MarchRaBBiT/RNA/RNA.kicad_pcb

## KiCad design RNA.kicad_pcb (2019-11-05)

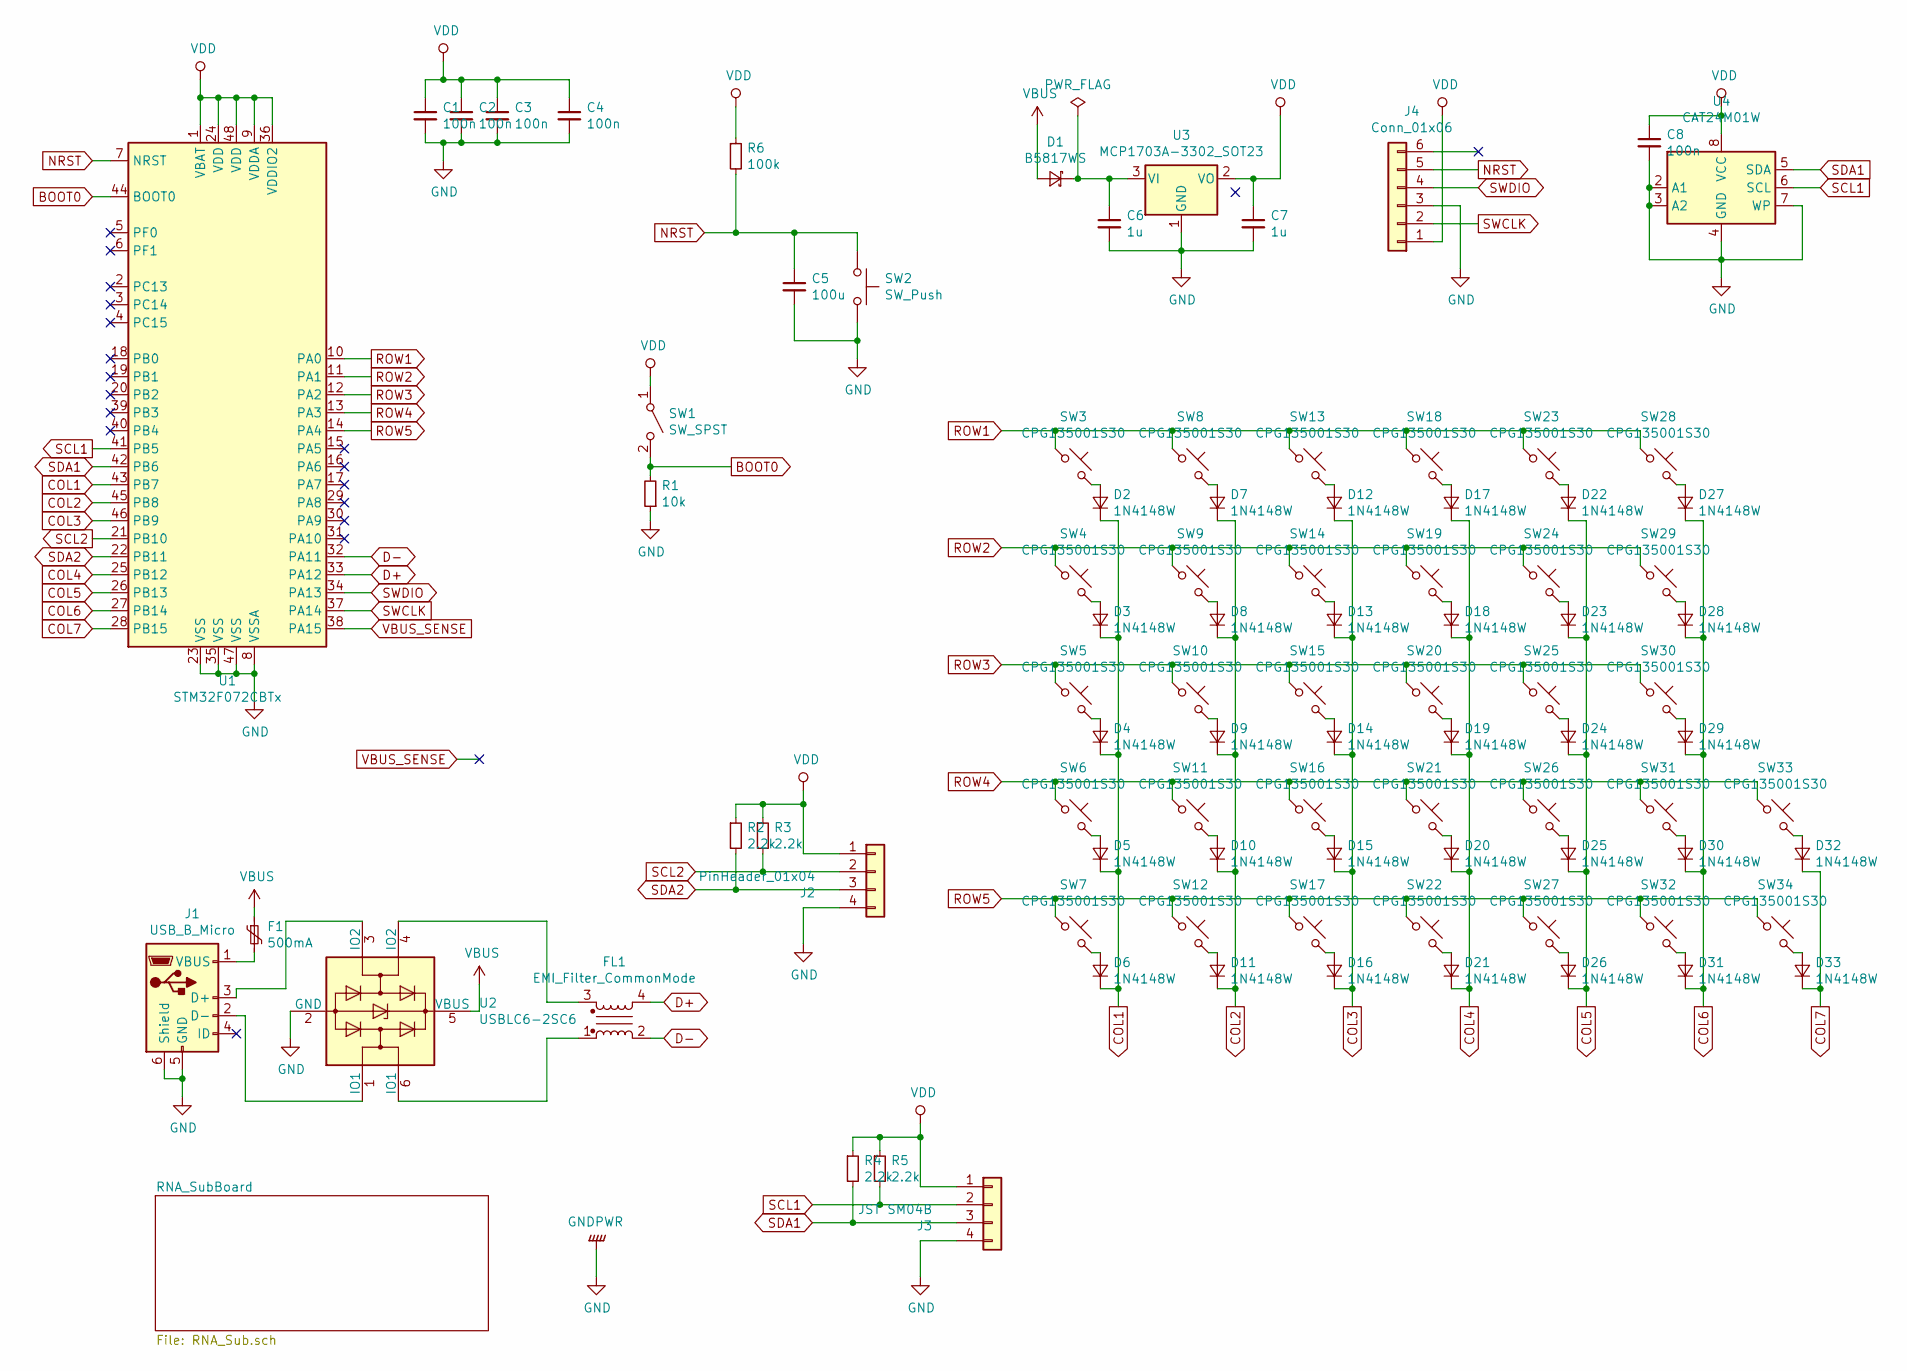
[picture p1: schematic RNA.sch]

Parts:
C1, C2, C3, C4, C8: 100n; C_0603_1608Metric; LCSC_Parts_No C14663
C5: 100u; C_0603_1608Metric; LCSC_Parts_No C14663
C6, C7: 1u; C_0603_1608Metric; LCSC_Parts_No C15849
D1: B5817WS; D_SOD-323; LCSC_Parts_No C179720
D2, D3, D4, D5, D6, D7, D8, D9, D10, D11, D12, D13, D14, D15, D16, D17, D18, D19, D20, D21, D22, D23, D24, D25, D26, D27, D28, D29, D30, D31, D32, D33: 1N4148W; D_SOD-123; LCSC_Parts_No C81598
F1: 500mA; Fuse_1206_3216Metric; LCSC_Parts_No C261942
FL1: EMI_Filter_CommonMode; ACM2012-121-2P-T002; LCSC_Parts_No C76571
J1: USB_B_Micro; USB_Micro-B_Molex-105017-0001
J2: PinHeader_01x04; PinHeader_1x04_P2.54mm_Vertical
J3: JST SM04B; JST_SH_SM04B-SRSS-TB_1x04-1MP_P1.00mm_Horizontal
J4: Conn_01x06; PinHeader_2x03_P2.54mm_Vertical
R1: 10k; R_0603_1608Metric; LCSC_Parts_No C25804
R2, R3, R4, R5: 2.2k; R_0603_1608Metric; LCSC_Parts_No C4190
R6: 100k; 0603; LCSC_Parts_No C25803
SW1: SW_SPST; SW_DIP_SPSTx01_Slide_6.7x4.1mm_W8.61mm_P2.54mm_LowProfile
SW2: SW_Push; Panasonic_EVQPUL_EVQPUC
SW3, SW4, SW5, SW6, SW7, SW8, SW9, SW10, SW11, SW12, SW13, SW14, SW15, SW16, SW17, SW18, SW19, SW20, SW21, SW22, SW23, SW24, SW25, SW26, SW27, SW28, SW29, SW30, SW31, SW32, SW33, SW34: CPG135001S30; PG1350_socket
U1: STM32F072CBTx; LQFP-48_7x7mm_P0.5mm; JLCSC_Parts_No C81720
U2: USBLC6-2SC6; SOT-23-6; LCSC_Parts_No C7519
U3: MCP1703A-3302_SOT23; SOT-23; JLCSC_Parts_No C144183
U4: CAT24M01W; SOIC-8_3.9x4.9mm_P1.27mm; LCSC_Parts_No C62273

Connections:
BOOT0: R1.2, SW1.2 (B), U1.44 (BOOT0)
COL1: D2.1 (K), D3.1 (K), D4.1 (K), D5.1 (K), D6.1 (K), U1.43 (PB7)
COL2: D7.1 (K), D8.1 (K), D9.1 (K), D10.1 (K), D11.1 (K), U1.45 (PB8)
COL3: D12.1 (K), D13.1 (K), D14.1 (K), D15.1 (K), D16.1 (K), U1.46 (PB9)
COL4: D17.1 (K), D18.1 (K), D19.1 (K), D20.1 (K), D21.1 (K), U1.25 (PB12)
COL5: D22.1 (K), D23.1 (K), D24.1 (K), D25.1 (K), D26.1 (K), U1.26 (PB13)
COL6: D27.1 (K), D28.1 (K), D29.1 (K), D30.1 (K), D31.1 (K), U1.27 (PB14)
COL7: D32.1 (K), D33.1 (K), U1.28 (PB15)
D+: FL1.4, U1.33 (PA12)
D-: FL1.2, U1.32 (PA11)
GND: C1.2, C2.2, C3.2, C4.2, C5.2, C6.2, C7.2, C8.2, J1.5 (GND), J1.6 (Shield), J2.4, J3.4, J4.3, R1.1, SW2.2, U1.8 (VSSA), U1.23 (VSS), U1.35 (VSS), U1.47 (VSS), U2.2 (GND), U3.1 (GND), U4.2 (A1), U4.3 (A2), U4.4 (GND), U4.7 (WP); also elsewhere on the board
NRST: C5.1, J4.5, R6.2, SW2.1, U1.7 (NRST)
unnamed: C6.1, D1.1 (K), U3.3 (VI)
unnamed: D2.2 (A), SW3.2
unnamed: D3.2 (A), SW4.2
unnamed: D4.2 (A), SW5.2
unnamed: D5.2 (A), SW6.2
unnamed: D6.2 (A), SW7.2
unnamed: D7.2 (A), SW8.2
unnamed: D8.2 (A), SW9.2
unnamed: D9.2 (A), SW10.2
unnamed: D10.2 (A), SW11.2
unnamed: D11.2 (A), SW12.2
unnamed: D12.2 (A), SW13.2
unnamed: D13.2 (A), SW14.2
unnamed: D14.2 (A), SW15.2
unnamed: D15.2 (A), SW16.2
unnamed: D16.2 (A), SW17.2
unnamed: D17.2 (A), SW18.2
unnamed: D18.2 (A), SW19.2
unnamed: D19.2 (A), SW20.2
unnamed: D20.2 (A), SW21.2
unnamed: D21.2 (A), SW22.2
unnamed: D22.2 (A), SW23.2
unnamed: D23.2 (A), SW24.2
unnamed: D24.2 (A), SW25.2
unnamed: D25.2 (A), SW26.2
unnamed: D26.2 (A), SW27.2
unnamed: D27.2 (A), SW28.2
unnamed: D28.2 (A), SW29.2
unnamed: D29.2 (A), SW30.2
unnamed: D30.2 (A), SW31.2
unnamed: D31.2 (A), SW32.2
unnamed: D32.2 (A), SW33.2
unnamed: D33.2 (A), SW34.2
unnamed: F1.2, J1.1 (VBUS)
unnamed: FL1.1, U2.6 (IO1)
unnamed: FL1.3, U2.4 (IO2)
unnamed: J1.2 (D-), U2.1 (IO1)
unnamed: J1.3 (D+), U2.3 (IO2)
ROW1: SW3.1, SW8.1, SW13.1, SW18.1, SW23.1, SW28.1, U1.10 (PA0)
ROW2: SW4.1, SW9.1, SW14.1, SW19.1, SW24.1, SW29.1, U1.11 (PA1)
ROW3: SW5.1, SW10.1, SW15.1, SW20.1, SW25.1, SW30.1, U1.12 (PA2)
ROW4: SW6.1, SW11.1, SW16.1, SW21.1, SW26.1, SW31.1, SW33.1, U1.13 (PA3)
ROW5: SW7.1, SW12.1, SW17.1, SW22.1, SW27.1, SW32.1, SW34.1, U1.14 (PA4)
SCL1: J3.2, R5.2, U1.41 (PB5), U4.6 (SCL)
SCL2: J2.2, R3.2, U1.21 (PB10)
SDA1: J3.3, R4.2, U1.42 (PB6), U4.5 (SDA)
SDA2: J2.3, R2.2, U1.22 (PB11)
SWCLK: J4.2, U1.37 (PA14)
SWDIO: J4.4, U1.34 (PA13)
VBUS: D1.2 (A), F1.1, U2.5 (VBUS)
VBUS_SENSE: U1.38 (PA15)
VDD: C1.1, C2.1, C3.1, C4.1, C7.1, C8.1, J2.1, J3.1, J4.1, R2.1, R3.1, R4.1, R5.1, R6.1, SW1.1 (A), U1.1 (VBAT), U1.9 (VDDA), U1.24 (VDD), U1.36 (VDDIO2), U1.48 (VDD), U3.2 (VO), U4.8 (VCC); also elsewhere on the board

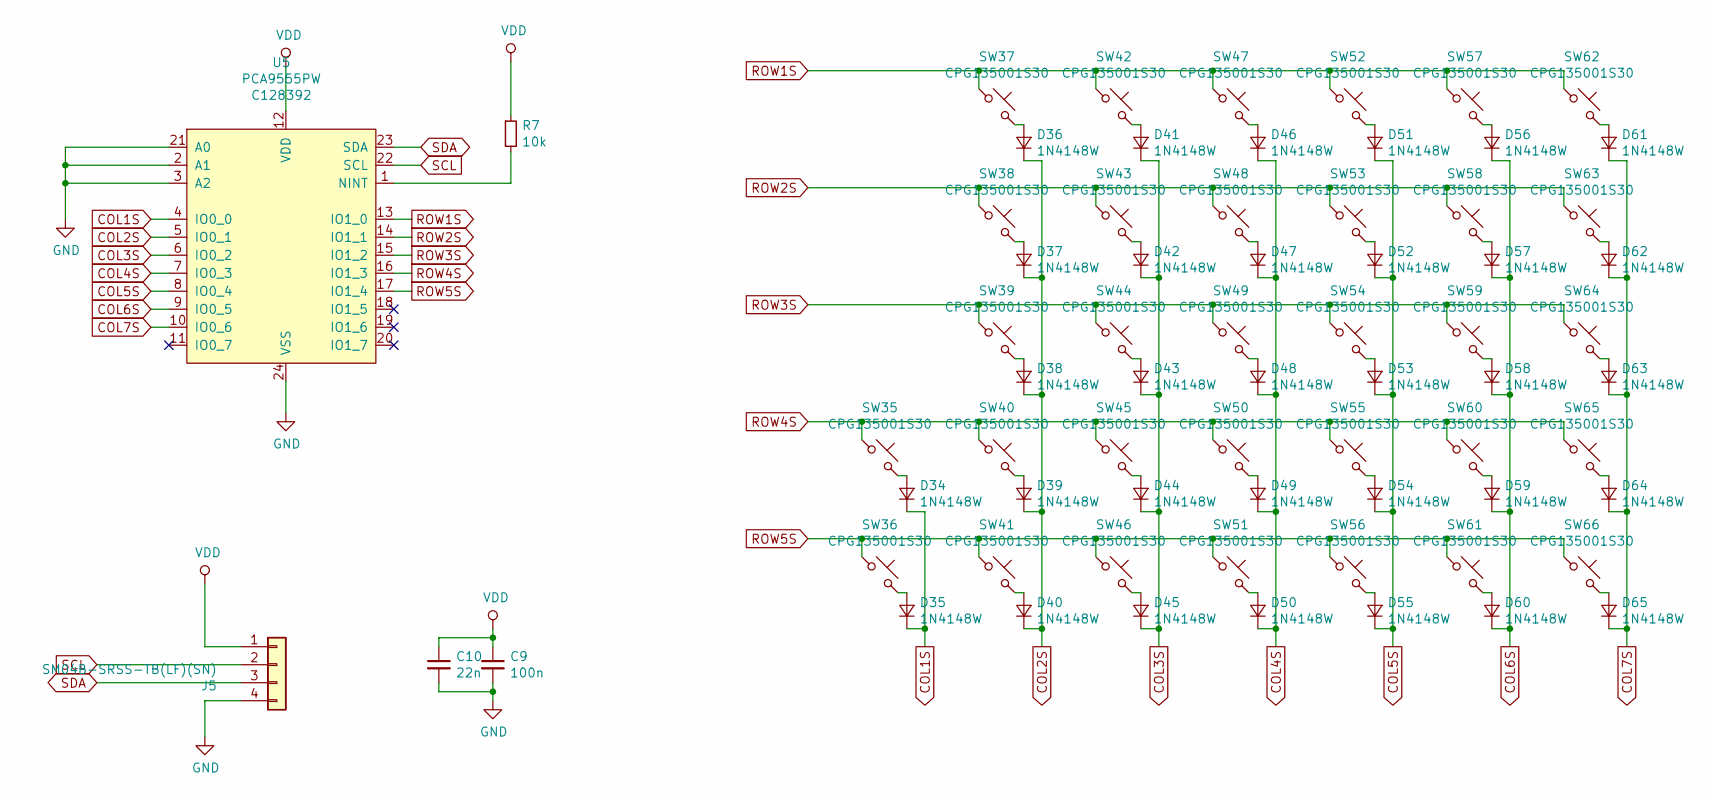
[picture p2: schematic RNA_Sub.sch]

Parts:
C9: 100n; C_0603_1608Metric
C10: 22n; C_0603_1608Metric; LCSC_Parts_No C21122
D34, D35, D36, D37, D38, D39, D40, D41, D42, D43, D44, D45, D46, D47, D48, D49, D50, D51, D52, D53, D54, D55, D56, D57, D58, D59, D60, D61, D62, D63, D64, D65: 1N4148W; D_SOD-123; LCSC_Parts_No C81598
J5: SM04B-SRSS-TB(LF)(SN); JST_SH_SM04B-SRSS-TB_1x04-1MP_P1.00mm_Horizontal
R7: 10k; R_0603_1608Metric; LCSC_Parts_No C25804
SW35, SW36, SW37, SW38, SW39, SW40, SW41, SW42, SW43, SW44, SW45, SW46, SW47, SW48, SW49, SW50, SW51, SW52, SW53, SW54, SW55, SW56, SW57, SW58, SW59, SW60, SW61, SW62, SW63, SW64, SW65, SW66: CPG135001S30; PG1350_socket
U5: PCA9555PW; TSSOP-24_4.4x7.8mm_P0.65mm; LCSC_Parts_No C128392

Connections:
COL1S: D34.1 (K), D35.1 (K), U5.4 (IO0_0)
COL2S: D36.1 (K), D37.1 (K), D38.1 (K), D39.1 (K), D40.1 (K), U5.5 (IO0_1)
COL3S: D41.1 (K), D42.1 (K), D43.1 (K), D44.1 (K), D45.1 (K), U5.6 (IO0_2)
COL4S: D46.1 (K), D47.1 (K), D48.1 (K), D49.1 (K), D50.1 (K), U5.7 (IO0_3)
COL5S: D51.1 (K), D52.1 (K), D53.1 (K), D54.1 (K), D55.1 (K), U5.8 (IO0_4)
COL6S: D56.1 (K), D57.1 (K), D58.1 (K), D59.1 (K), D60.1 (K), U5.9 (IO0_5)
COL7S: D61.1 (K), D62.1 (K), D63.1 (K), D64.1 (K), D65.1 (K), U5.10 (IO0_6)
GND: C9.2, C10.2, J5.4, U5.2 (A1), U5.3 (A2), U5.21 (A0), U5.24 (VSS); also elsewhere on the board
unnamed: D34.2 (A), SW35.2
unnamed: D35.2 (A), SW36.2
unnamed: D36.2 (A), SW37.2
unnamed: D37.2 (A), SW38.2
unnamed: D38.2 (A), SW39.2
unnamed: D39.2 (A), SW40.2
unnamed: D40.2 (A), SW41.2
unnamed: D41.2 (A), SW42.2
unnamed: D42.2 (A), SW43.2
unnamed: D43.2 (A), SW44.2
unnamed: D44.2 (A), SW45.2
unnamed: D45.2 (A), SW46.2
unnamed: D46.2 (A), SW47.2
unnamed: D47.2 (A), SW48.2
unnamed: D48.2 (A), SW49.2
unnamed: D49.2 (A), SW50.2
unnamed: D50.2 (A), SW51.2
unnamed: D51.2 (A), SW52.2
unnamed: D52.2 (A), SW53.2
unnamed: D53.2 (A), SW54.2
unnamed: D54.2 (A), SW55.2
unnamed: D55.2 (A), SW56.2
unnamed: D56.2 (A), SW57.2
unnamed: D57.2 (A), SW58.2
unnamed: D58.2 (A), SW59.2
unnamed: D59.2 (A), SW60.2
unnamed: D60.2 (A), SW61.2
unnamed: D61.2 (A), SW62.2
unnamed: D62.2 (A), SW63.2
unnamed: D63.2 (A), SW64.2
unnamed: D64.2 (A), SW65.2
unnamed: D65.2 (A), SW66.2
unnamed: R7.2, U5.1 (NINT)
ROW1S: SW37.1, SW42.1, SW47.1, SW52.1, SW57.1, SW62.1, U5.13 (IO1_0)
ROW2S: SW38.1, SW43.1, SW48.1, SW53.1, SW58.1, SW63.1, U5.14 (IO1_1)
ROW3S: SW39.1, SW44.1, SW49.1, SW54.1, SW59.1, SW64.1, U5.15 (IO1_2)
ROW4S: SW35.1, SW40.1, SW45.1, SW50.1, SW55.1, SW60.1, SW65.1, U5.16 (IO1_3)
ROW5S: SW36.1, SW41.1, SW46.1, SW51.1, SW56.1, SW61.1, SW66.1, U5.17 (IO1_4)
SCL: J5.2, U5.22 (SCL)
SDA: J5.3, U5.23 (SDA)
VDD: C9.1, C10.1, J5.1, R7.1, U5.12 (VDD); also elsewhere on the board

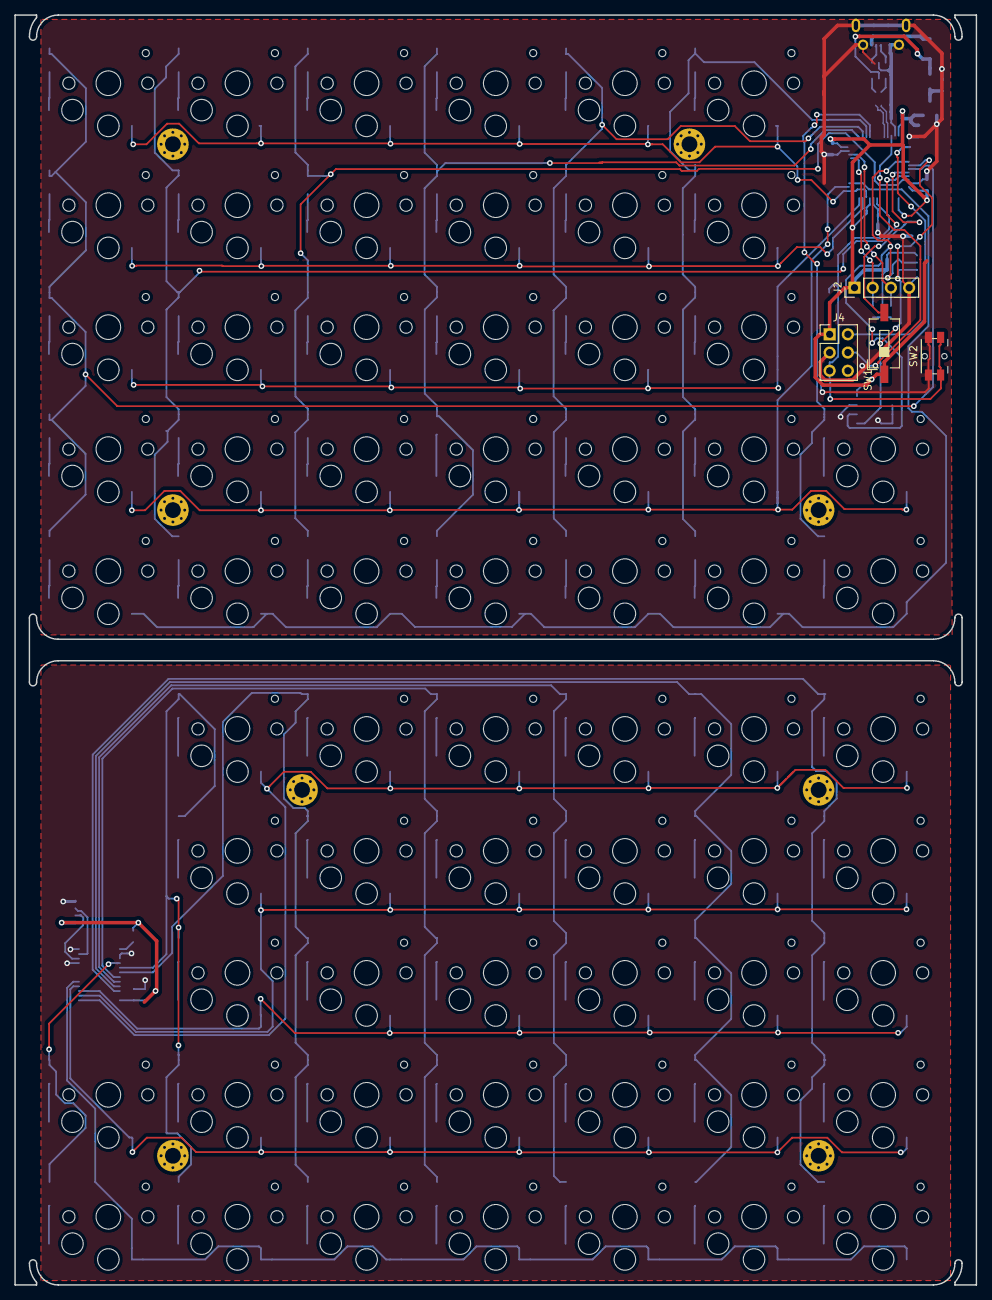
[picture p3: board RNA.kicad_pcb from above]

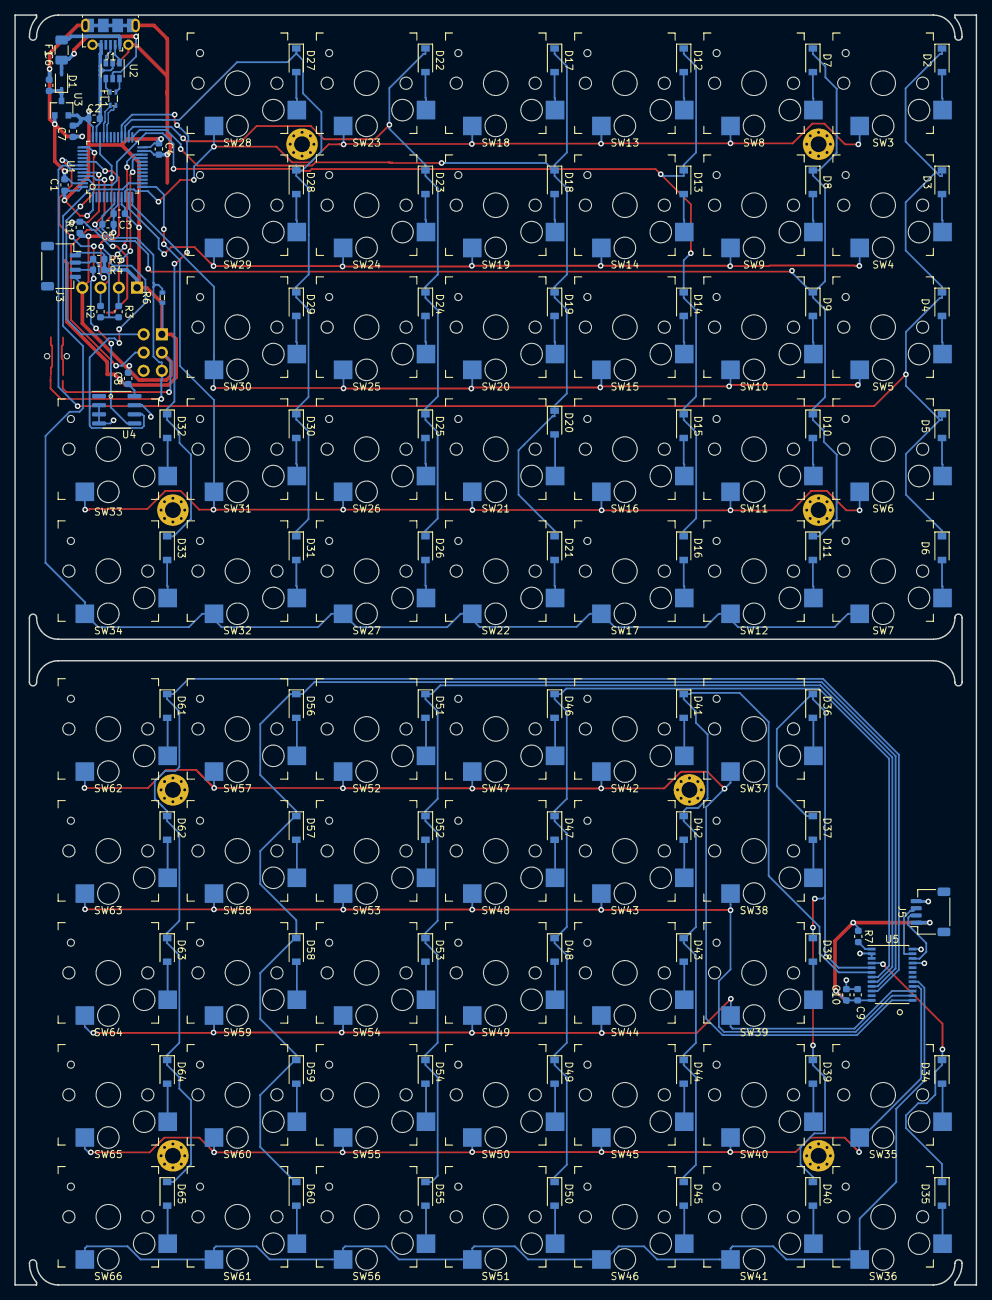
[picture p4: board RNA.kicad_pcb from below]

Board: 2 copper layers, 134.0 x 177.0 mm, 160 parts (92 on the bottom side), 110 nets.
