MarchRaBBiT/RNA/(commit log)

2019-01-23 add connectors
    [RNA.sch]
2019-01-23 add footprint
    [RNA.sch]
2019-01-23 add more footprint
    [RNA.sch]
2019-01-24 add more annotation
    [RNA.sch]
2019-01-25 add usb reset circuit
    [RNA.sch]
2019-01-27 add pcb
    [RNA.sch]
2019-06-08 fix pcb size
    [RNA.kicad_pcb]
2019-06-09 add sub(right-hand) keyboard
    [RNA.kicad_pcb, RNA.sch, RNA_Sub.sch]
2019-06-09 ready to alpha
    [RNA.kicad_pcb, RNA.sch]
2019-06-13 update annotation
    [RNA.kicad_pcb, RNA.sch, RNA_Sub.sch]
2019-06-19 modify module
    [RNA.kicad_pcb, RNA.sch, RNA_Sub.sch]
2019-06-19 arrange reference footprint
    [RNA.kicad_pcb]
2019-06-26 Move conflicted I2C1 to I2C3
    [RNA.kicad_pcb, RNA.sch]
2019-10-23 chenge microcontroller from STM32L433CCT to STM32F072BCT
    [RNA.kicad_pcb, RNA.sch, RNA_Sub.sch]
2019-11-05 add pull-up resistor for NRST
    [RNA.kicad_pcb, RNA.sch, RNA_Sub.sch]
